454bio/hardware/README.md

# hardware

Models for a [cost-effective TIRF microscope](https://454.bio/docs/build/) and adjacent hardware.

## Legal

The attached LICENSE solely authorizes the use of the hardware models contained in this repository and provides no other license.

Usage of Lightning Terminators™️ is governed by a separate license provided upon purchase.
