454bio/hardware/Instrument/Lab Base v6.step

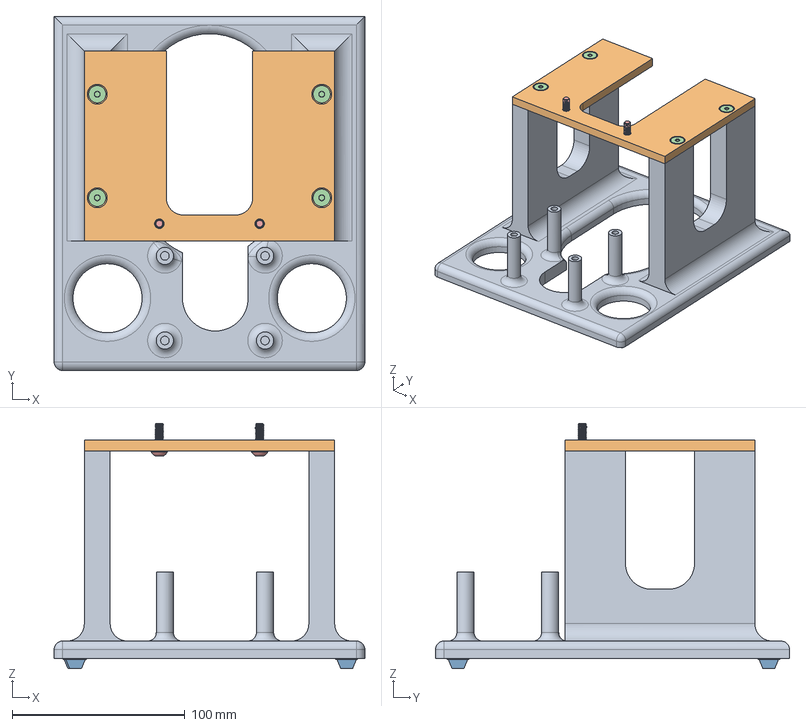
[picture p1: CAD file, 2024-01-19]
Instrument/Lab Base v6.step
180.0 x 205.0 x 142.0 mm
Lab Stand Base
Lab Stand Plate
95495K24_Adhesive-Back Bumpers x 4
92125A212_18-8 Stainless Steel Hex Drive Flat Head Screw x 4
92095A212_Button Head Hex Drive Screw x 2
