454bio/hardware/Lab Support/MyFuge Sequencing Reservoir centrifuge adapter.step

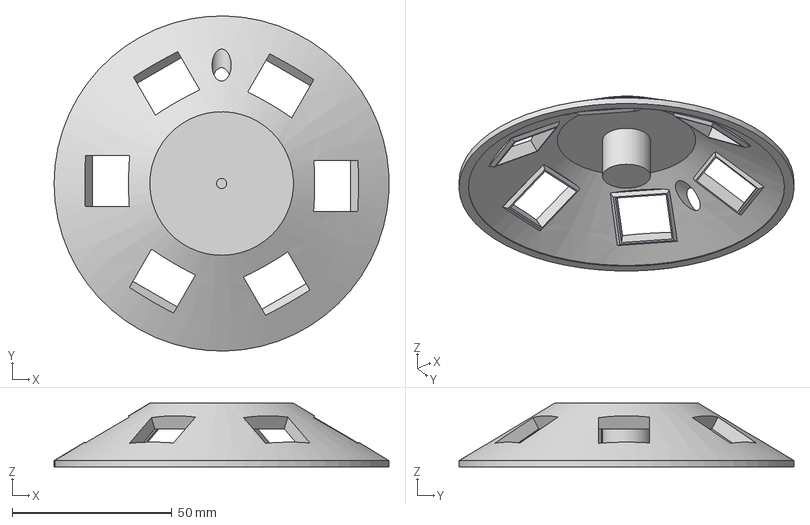
[picture p2: CAD file, 2024-01-22]
Lab Support/MyFuge Sequencing Reservoir centrifuge adapter.step
104.9 x 105.0 x 20.0 mm
