454bio/hardware/Lab Support/Vertical Slide Holder Washing Fixture.step

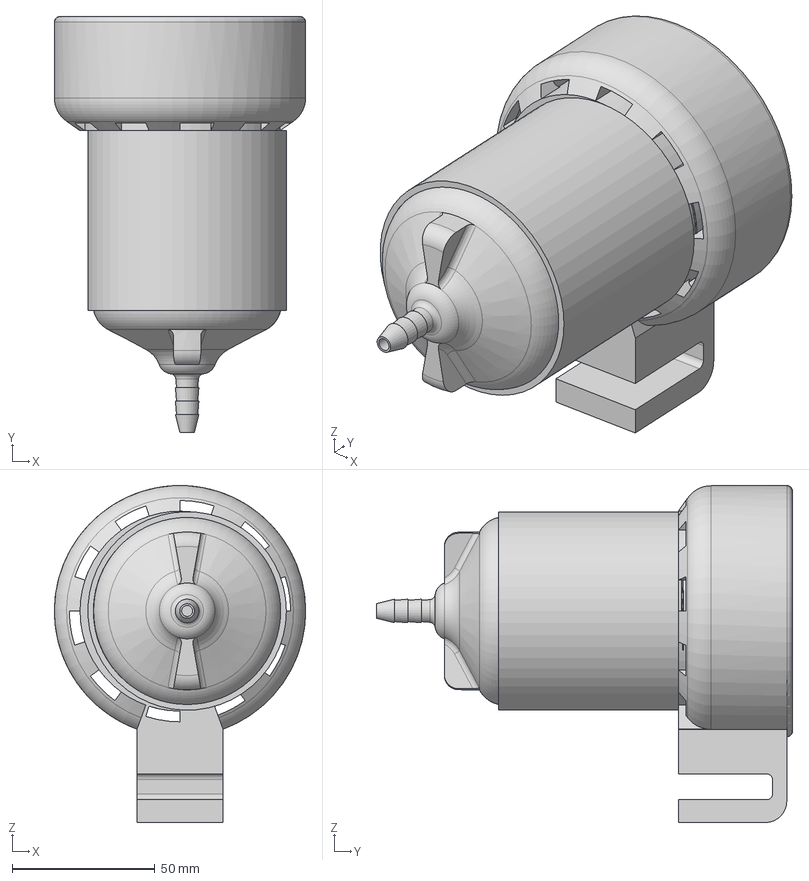
[picture p4: CAD file, 2024-01-20]
Lab Support/Vertical Slide Holder Washing Fixture.step
88.0 x 145.7 x 118.0 mm
250mL TOP v6
Post
Bottom
Liquid Flower
Top
