454bio/hardware/Lab Support/Vertical slide holder.step

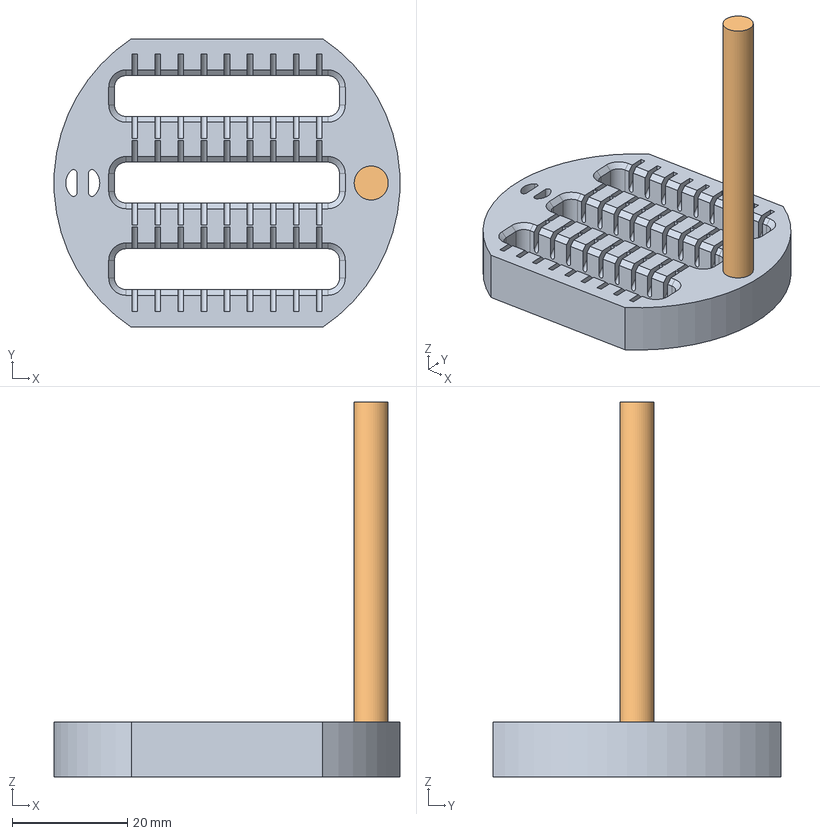
[picture p5: CAD file, 2024-01-20]
Lab Support/Vertical slide holder.step
59.9 x 50.0 x 65.0 mm
250mL TOP v6
Post
