454bio/hardware/Lab Support/Vertical Slide Holder Drying Fixture.step

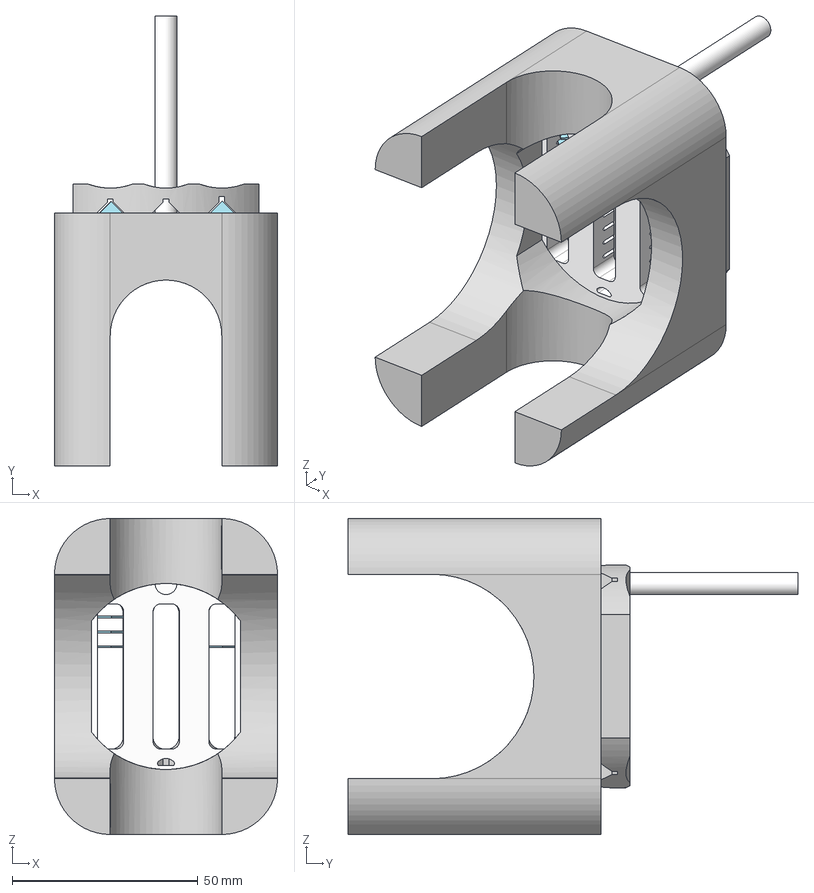
[picture p6: CAD file, 2024-01-20]
Lab Support/Vertical Slide Holder Drying Fixture.step
60.0 x 121.0 x 85.0 mm
SlideHolder96WellFormFactor v2
250mL TOP v6
Post
Slide x 4
Dryder Slide Lid
