454bio/hardware/Lab Support/Open vertical Reaction chamber - teflon.step

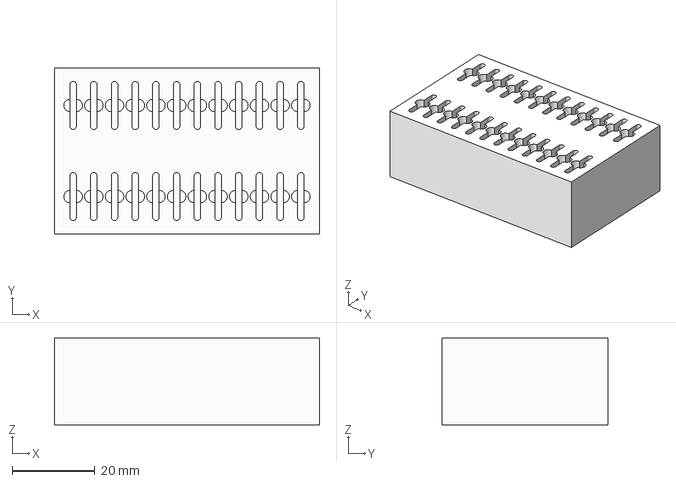
[picture p7: CAD file, 2024-01-20]
Lab Support/Open vertical Reaction chamber - teflon.step
64.0 x 40.0 x 21.0 mm
