454bio/hardware/Lab Support/Slide processing Casette washing station.step

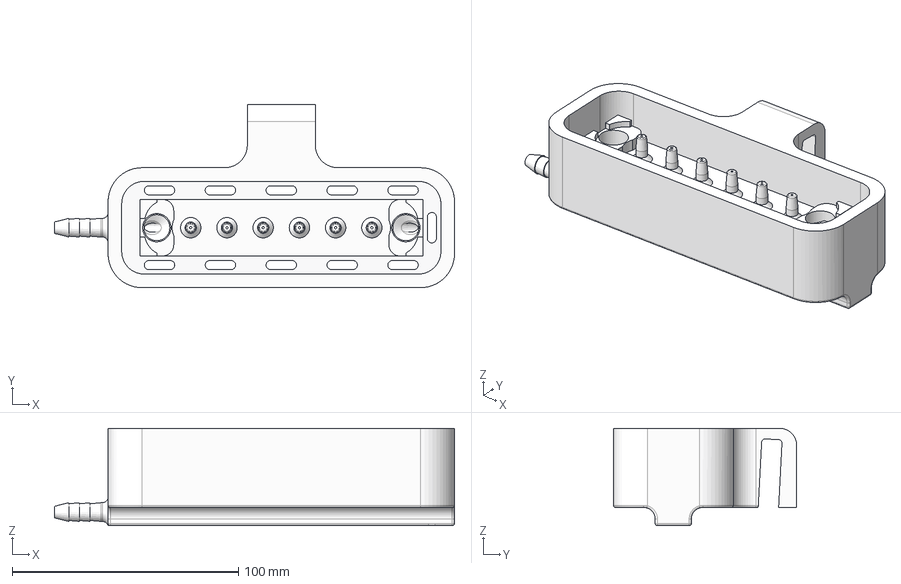
[picture p8: CAD file, 2024-01-20]
Lab Support/Slide processing Casette washing station.step
176.7 x 81.0 x 43.0 mm
