454bio/hardware/Lab Support/3 reservoir heater block insert v1.step

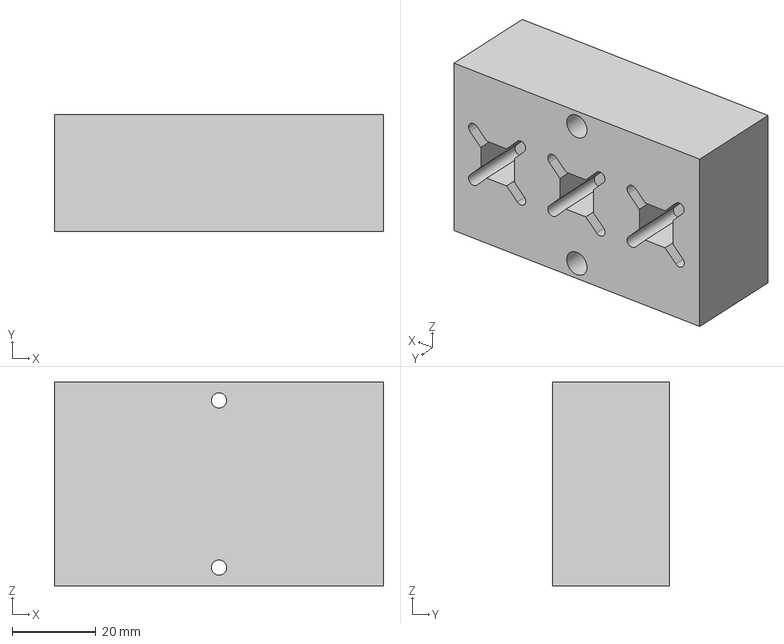
[picture p9: CAD file, 2024-01-19]
Lab Support/3 reservoir heater block insert v1.step
78.8 x 28.0 x 48.8 mm
