454bio/hardware/Lab Support/3D Print MultiColor Reservoir Holding Block v1.step

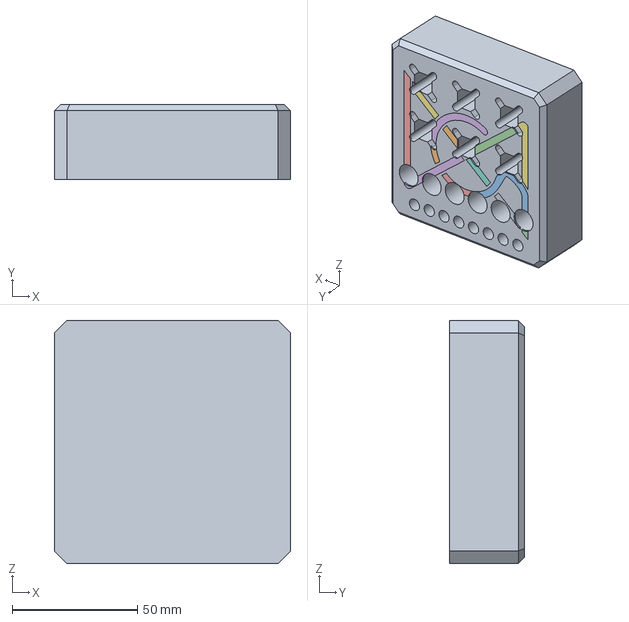
[picture p10: CAD file, 2024-01-19]
Lab Support/3D Print MultiColor Reservoir Holding Block v1.step
94.4 x 30.0 x 97.2 mm
