454bio/hardware/Lab Support/Machinable Reservoir Holding Block v1.step

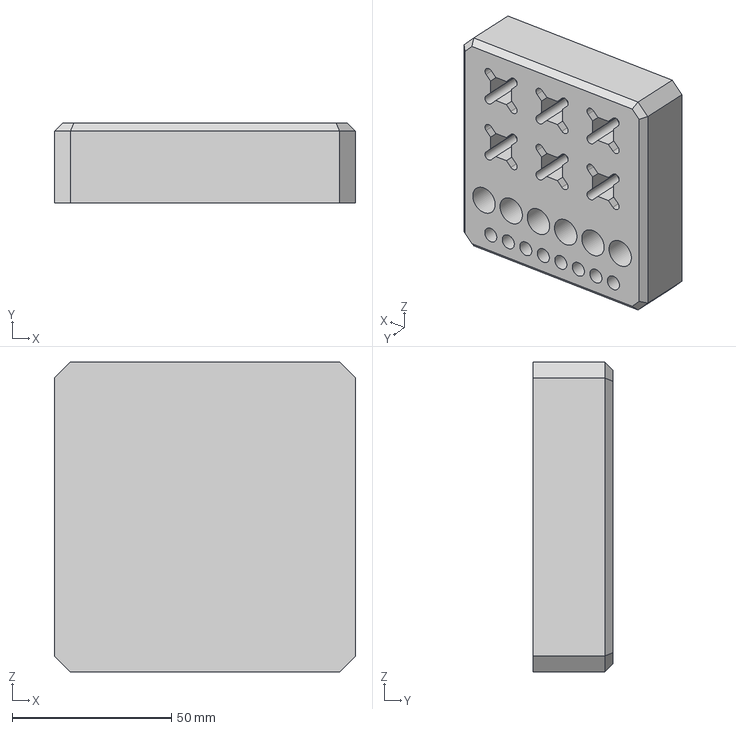
[picture p11: CAD file, 2024-01-19]
Lab Support/Machinable Reservoir Holding Block v1.step
94.4 x 25.0 x 97.2 mm
