454bio/hardware/(commit log)

2024-01-19 Add content
    [3 reservoir heater block insert v1.step, 3D Print MultiColor Reservoir Holding Block v1.step, Lab Base v6.step, Machinable Reservoir Holding Block v1.step]
2024-01-20 Updates from Wolfgang
    [3 reservoir heater block insert v1.step, 3D Print MultiColor Reservoir Holding Block v1.step, Lab Base v6.step, Machinable Reservoir Holding Block v1.step, Open vertical Reaction chamber - teflon.step, Slide processing Casette washing station.step, Slide processing casette.step, Vertical Slide Holder Drying Fixture.step]
